dasBente/m3-modular-puzzle/README.md

# m3-modular-puzzle
The aim of this project is the implementation of a modular puzzle system including a default casing and some pre-implemented modules accompanying a controller that enables communication between a desired number of puzzle modules that can be exchanged at will.
