dasBente/m3-modular-puzzle/Modules/Module1/PCB/M3-Module1.brd

## EAGLE design Modules/Module1/PCB/M3-Module1.brd (2016-07-14)

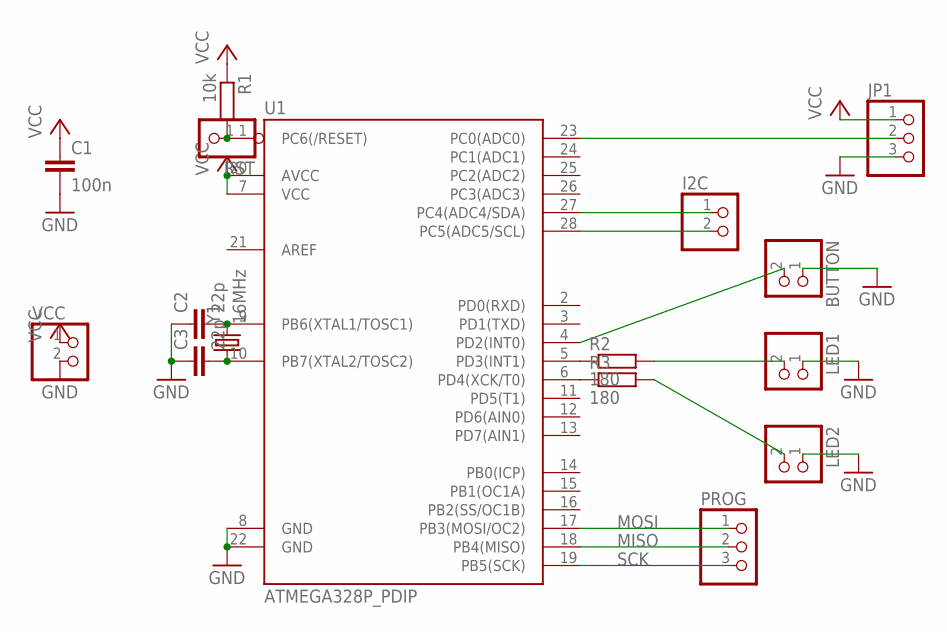
[picture p1: schematic M3-Module1.sch]

Parts:
BUTTON: PINHD-1X2; 1X02
C1: 100n; C025-025X050
C2, C3: 22p; C025-025X050
I2C: PINHD-1X2; 1X02
JP1: PINHD-1X3; 1X03
LED1, LED2: PINHD-1X2; 1X02
PROG: PINHD-1X3; 1X03
R1: 10k; 0204/5
R2, R3: 180; 0204/5
RST: PINHD-1X1; 1X01
U1: ATMEGA328P_PDIP; DIL28-3
VCC: PINHD-1X2; 1X02
Y1: 16MHz; HC49US

Connections:
GND: BUTTON.1, C1.2, C2.1, C3.1, JP1.3, LED1.1, LED2.1, U1.8 (GND), U1.22 (GND), VCC.2
MISO: PROG.2, U1.18 (PB4(MISO))
MOSI: PROG.1, U1.17 (PB3(MOSI/OC2))
unnamed: R1.2, RST.1, U1.1 (PC6(/RESET))
unnamed: I2C.1, U1.27 (PC4(ADC4/SDA))
unnamed: I2C.2, U1.28 (PC5(ADC5/SCL))
unnamed: C2.2, U1.9 (PB6(XTAL1/TOSC1)), Y1.2
unnamed: C3.2, U1.10 (PB7(XTAL2/TOSC2)), Y1.1
unnamed: BUTTON.2, U1.4 (PD2(INT0))
unnamed: R2.1, U1.5 (PD3(INT1))
unnamed: R3.1, U1.6 (PD4(XCK/T0))
unnamed: LED1.2, R2.2
unnamed: LED2.2, R3.2
unnamed: JP1.2, U1.23 (PC0(ADC0))
SCK: PROG.3, U1.19 (PB5(SCK))
VCC: C1.1, JP1.1, R1.1, U1.7 (VCC), U1.20 (AVCC), VCC.1

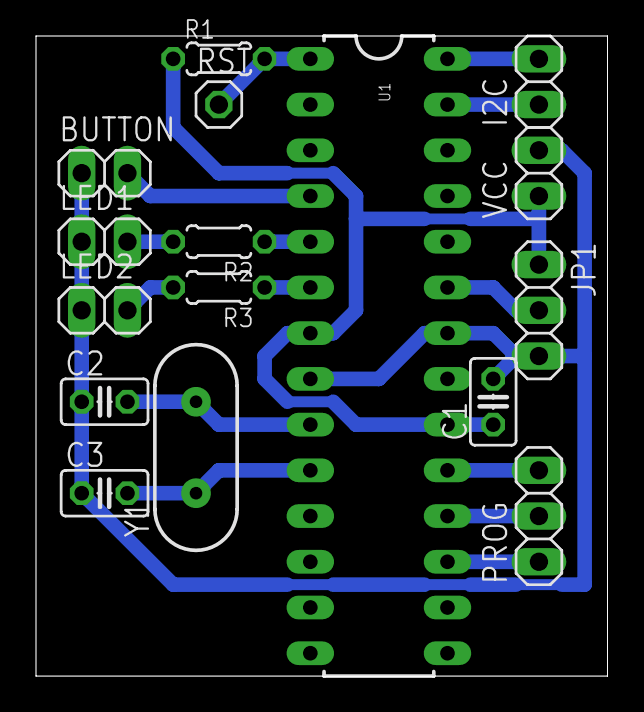
[picture p2: board M3-Module1.brd from above]

Board: 2 copper layers, 31.8 x 35.6 mm, 16 parts (0 on the bottom side), 16 nets.
