dasBente/m3-modular-puzzle/Modules/LogicModule/PCB/M3-LogicModule.brd

## EAGLE design Modules/LogicModule/PCB/M3-LogicModule.brd (2016-07-19)

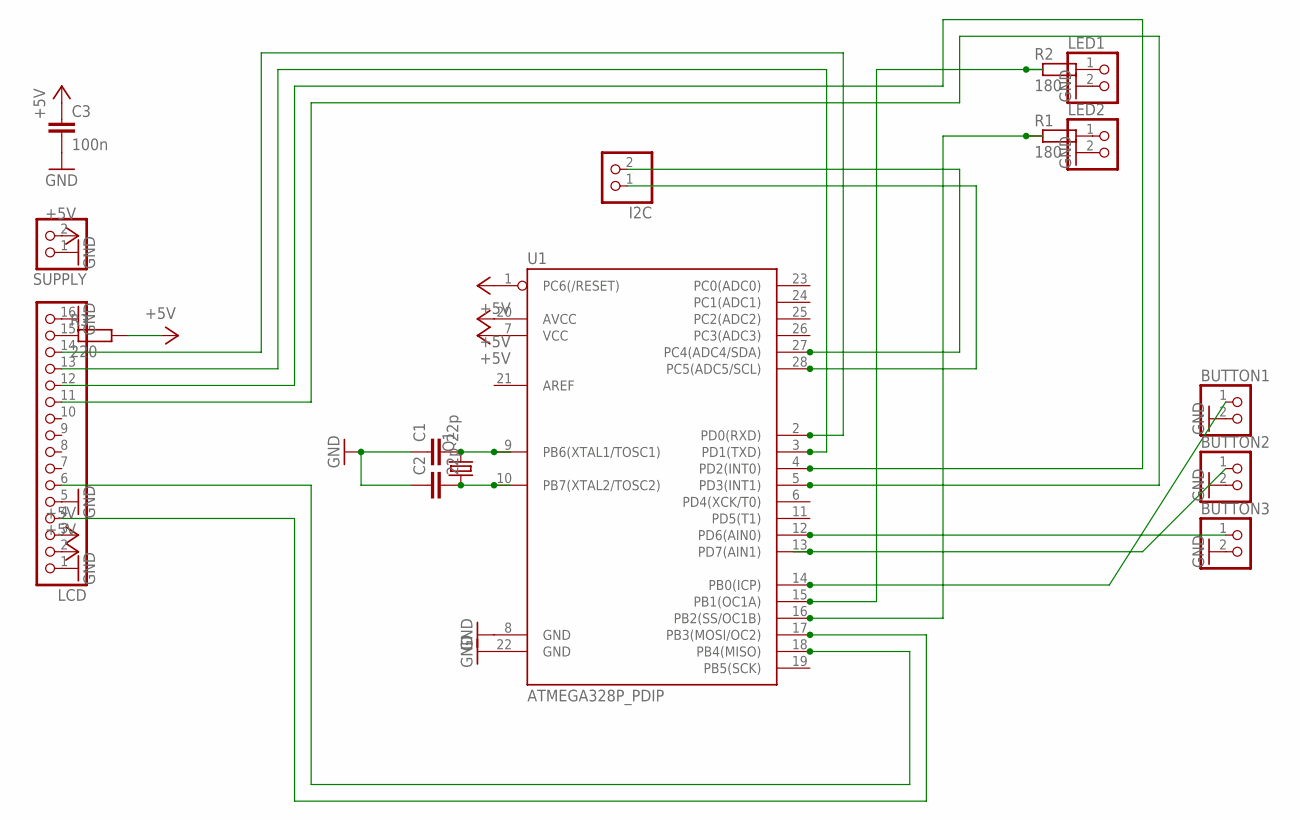
[picture p3: schematic M3-LogicModule.sch]

Parts:
BUTTON1, BUTTON2, BUTTON3: PINHD-1X2; 1X02
C1, C2: 22p; C025-025X050
C3: 100n; C2.5-3
I2C: PINHD-1X2; 1X02
LCD: PINHD-1X16; 1X16
LED1, LED2: PINHD-1X2; 1X02
Q1: CRYSTALHC49S; HC49/S
R1, R2: 180; 0309/12
R3: 220; 0309/10
SUPPLY: PINHD-1X2; 1X02
U1: ATMEGA328P_PDIP; DIL28-3

Connections:
+5V: C3.1, LCD.2, LCD.3, R3.2, SUPPLY.2, U1.1 (PC6(/RESET)), U1.7 (VCC), U1.20 (AVCC)
GND: BUTTON1.2, BUTTON2.2, BUTTON3.2, C1.1, C2.1, C3.2, LCD.1, LCD.5, LCD.16, LED1.2, LED2.2, SUPPLY.1, U1.8 (GND), U1.22 (GND)
unnamed: C1.2, Q1.2, U1.9 (PB6(XTAL1/TOSC1))
unnamed: LED2.1, R1.2
unnamed: LED1.1, R2.2
unnamed: R2.1, U1.15 (PB1(OC1A))
unnamed: R1.1, U1.16 (PB2(SS/OC1B))
unnamed: BUTTON1.1, U1.14 (PB0(ICP))
unnamed: BUTTON2.1, U1.13 (PD7(AIN1))
unnamed: BUTTON3.1, U1.12 (PD6(AIN0))
unnamed: C2.2, Q1.1, U1.10 (PB7(XTAL2/TOSC2))
unnamed: LCD.15, R3.1
unnamed: LCD.14, U1.2 (PD0(RXD))
unnamed: LCD.13, U1.3 (PD1(TXD))
unnamed: LCD.12, U1.4 (PD2(INT0))
unnamed: LCD.11, U1.5 (PD3(INT1))
unnamed: LCD.4, U1.17 (PB3(MOSI/OC2))
unnamed: LCD.6, U1.18 (PB4(MISO))
unnamed: I2C.1, U1.28 (PC5(ADC5/SCL))
unnamed: I2C.2, U1.27 (PC4(ADC4/SDA))

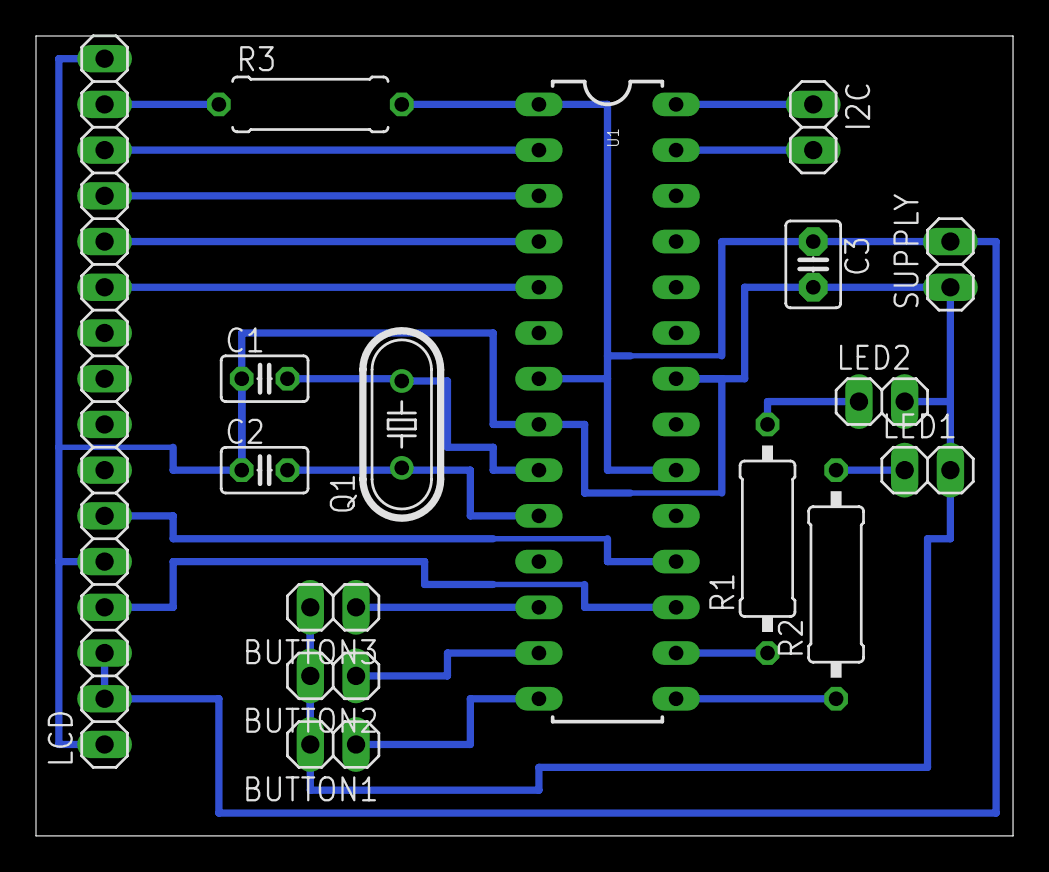
[picture p4: board M3-LogicModule.brd from above]

Board: 2 copper layers, 54.3 x 44.4 mm, 16 parts (0 on the bottom side), 20 nets.
