dasBente/m3-modular-puzzle/MainController/Schematic/main_controller.brd

## EAGLE design MainController/Schematic/main_controller.brd (2016-07-18)

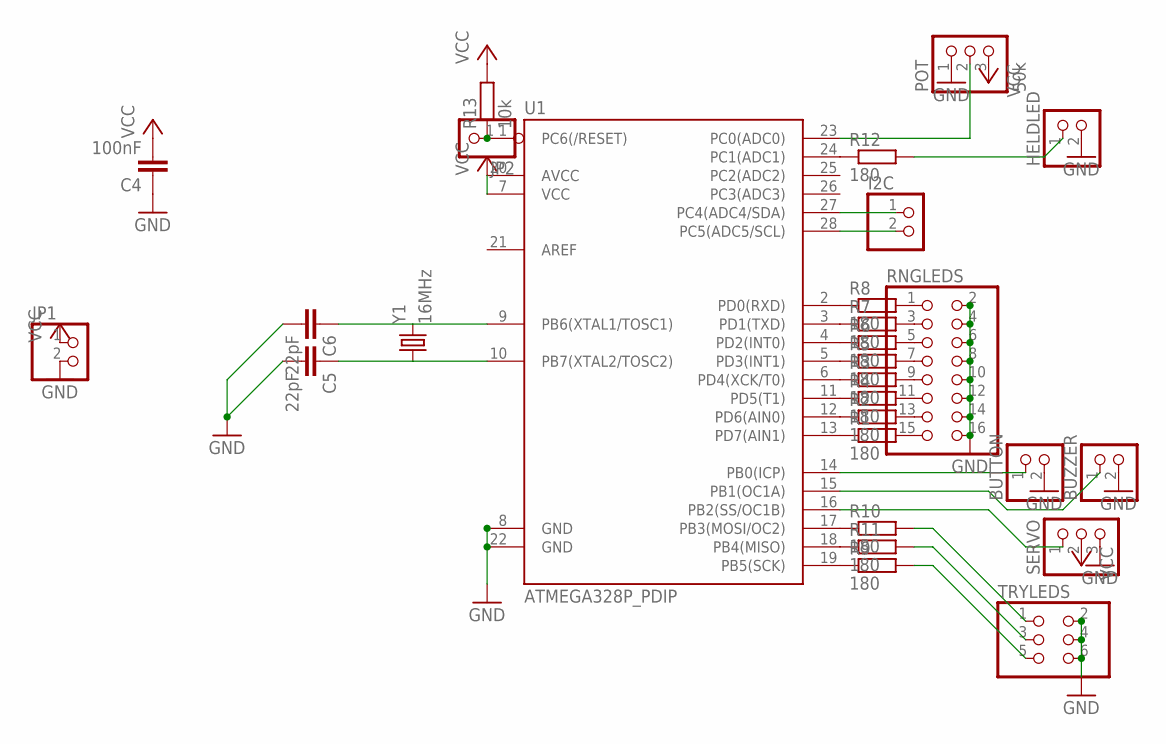
[picture p5: schematic main_controller.sch]

Parts:
BUTTON: PINHD-1X2; 1X02
BUZZER: PINHD-1X2; 1X02
C4: 100nF; C050-025X075
C5, C6: 22pF; C050-025X075
HELDLED: PINHD-1X2; 1X02
I2C: PINHD-1X2; 1X02
JP1: PINHD-1X2; 1X02
JP2: PINHD-1X1; 1X01
POT: 50k; 1X03
R1, R2, R3, R4, R5, R6, R7, R8, R9, R10, R11, R12: 180; 0207/7
R13: 10k; 0207/7
RNGLEDS: PINHD-2X8; 2X08
SERVO: PINHD-1X3; 1X03
TRYLEDS: PINHD-2X3; 2X03
U1: ATMEGA328P_PDIP; DIL28-3
Y1: 16MHz; HC49US

Connections:
GND: BUTTON.2, BUZZER.2, C4.1, C5.2, C6.2, HELDLED.2, JP1.2, POT.1, RNGLEDS.2, RNGLEDS.4, RNGLEDS.6, RNGLEDS.8, RNGLEDS.10, RNGLEDS.12, RNGLEDS.14, RNGLEDS.16, SERVO.3, TRYLEDS.2, TRYLEDS.4, TRYLEDS.6, U1.8 (GND), U1.22 (GND)
unnamed: C6.1, U1.9 (PB6(XTAL1/TOSC1)), Y1.2
unnamed: C5.1, U1.10 (PB7(XTAL2/TOSC2)), Y1.1
unnamed: POT.2, U1.23 (PC0(ADC0))
unnamed: R12.1, U1.24 (PC1(ADC1))
unnamed: I2C.1, U1.27 (PC4(ADC4/SDA))
unnamed: I2C.2, U1.28 (PC5(ADC5/SCL))
unnamed: R1.1, U1.13 (PD7(AIN1))
unnamed: R2.1, U1.12 (PD6(AIN0))
unnamed: R3.1, U1.6 (PD4(XCK/T0))
unnamed: R4.1, U1.11 (PD5(T1))
unnamed: R5.1, U1.5 (PD3(INT1))
unnamed: R6.1, U1.4 (PD2(INT0))
unnamed: R7.1, U1.3 (PD1(TXD))
unnamed: R8.1, U1.2 (PD0(RXD))
unnamed: R1.2, RNGLEDS.15
unnamed: R2.2, RNGLEDS.13
unnamed: R3.2, RNGLEDS.9
unnamed: R4.2, RNGLEDS.11
unnamed: R5.2, RNGLEDS.7
unnamed: R6.2, RNGLEDS.5
unnamed: R7.2, RNGLEDS.3
unnamed: R8.2, RNGLEDS.1
unnamed: R9.1, U1.19 (PB5(SCK))
unnamed: R10.1, U1.17 (PB3(MOSI/OC2))
unnamed: R11.1, U1.18 (PB4(MISO))
unnamed: HELDLED.1, R12.2
unnamed: R9.2, TRYLEDS.5
unnamed: R11.2, TRYLEDS.3
unnamed: R10.2, TRYLEDS.1
unnamed: BUTTON.1, U1.14 (PB0(ICP))
unnamed: BUZZER.1, U1.15 (PB1(OC1A))
unnamed: SERVO.1, U1.16 (PB2(SS/OC1B))
unnamed: JP2.1, R13.1, U1.1 (PC6(/RESET))
VCC: C4.2, JP1.1, POT.3, R13.2, SERVO.2, U1.7 (VCC), U1.20 (AVCC)

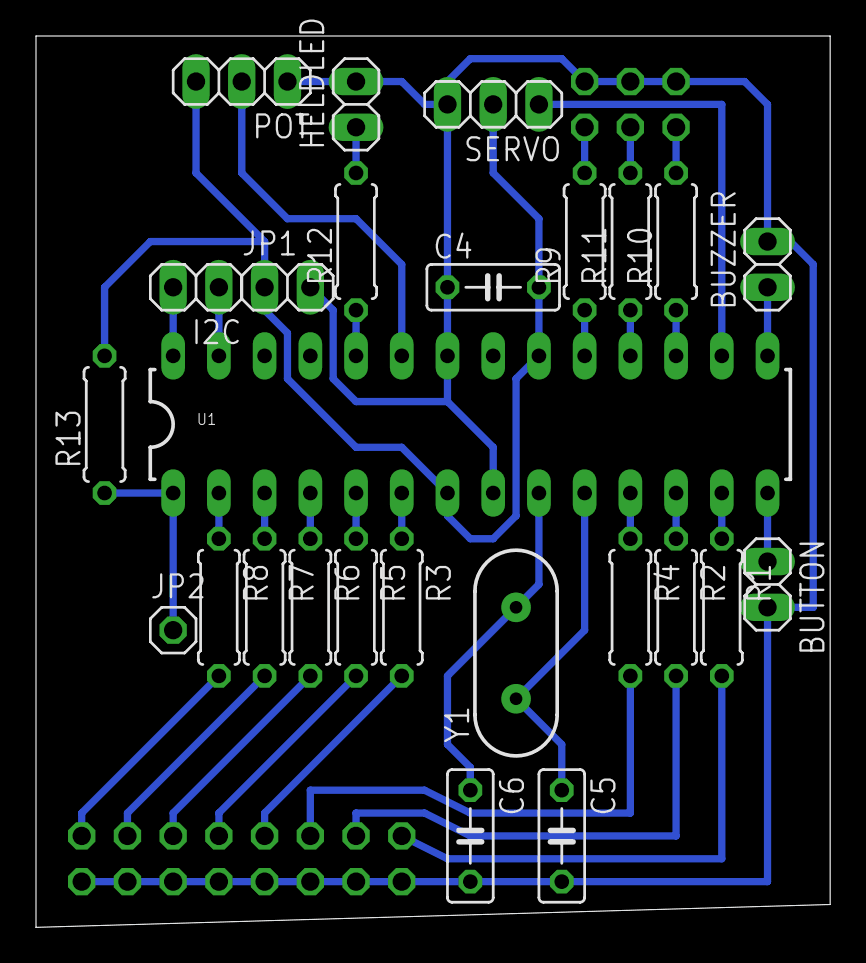
[picture p6: board main_controller.brd from above]

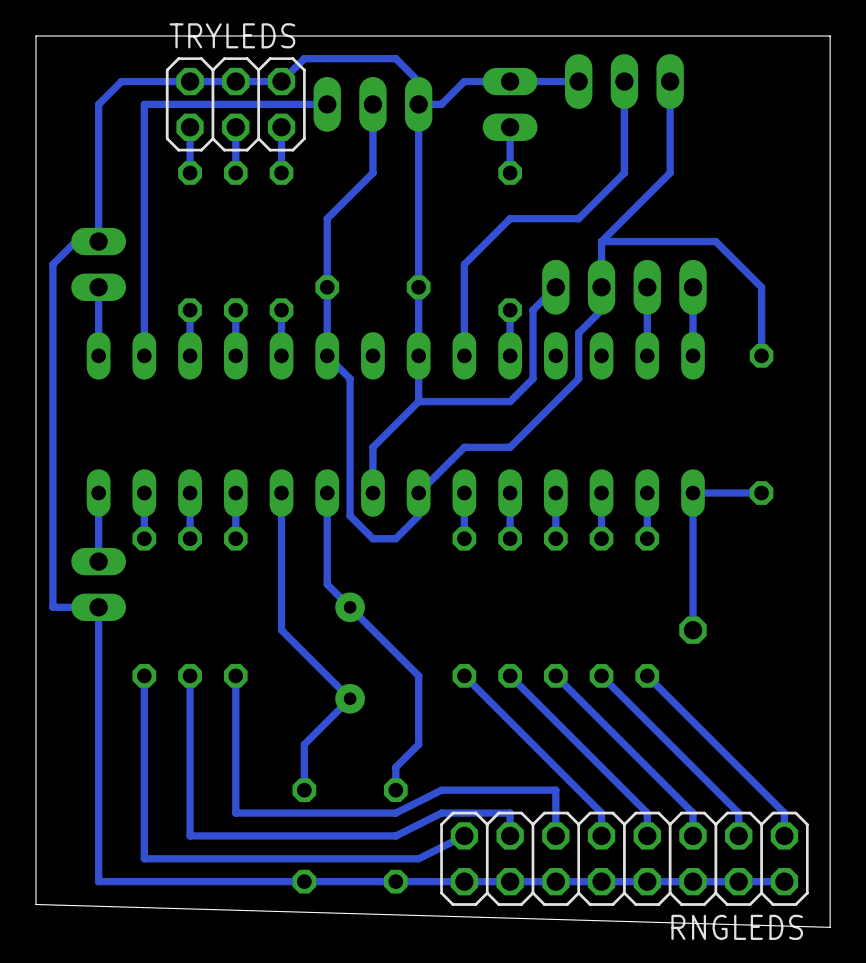
[picture p7: board main_controller.brd from below]

Board: 2 copper layers, 44.1 x 49.5 mm, 28 parts (2 on the bottom side), 35 nets.
