dasBente/m3-modular-puzzle/LogicModule/Instructions/Instructions.tex

\documentclass[a4paper, 12pt]{article}
\usepackage[utf8]{inputenc}
\usepackage{geometry}

\geometry{a4paper, left=15mm, right=20mm, top=2cm, bottom=2cm}
\setlength{\parskip}{1em}
\setlength{\parindent}{0pt}

\begin{document}

\section*{Solution instructions for the logic module}

The display shows a propositional logical formula with four variables. You have to change the operators in order to make the interpretation true. The last 4 LEDs on the main module represent the four variables: the last LED is on, if the fourth variable is true.

\end{document}
