dasBente/m3-modular-puzzle/Module1/Instructions/Instructions.tex

\documentclass[a4paper, 12pt]{article}
\usepackage[utf8]{inputenc}
\usepackage{geometry}

\geometry{a4paper, left=15mm, right=20mm, top=2cm, bottom=2cm}
\setlength{\parskip}{1em}
\setlength{\parindent}{0pt}

\begin{document}

\section*{Solution instructions for module 1}

There are six resistors of which you can choose. Your comrade has to pick the right one, depending on the eight LEDs on the main module. The first match is the correct answer:
\begin{itemize}
\setlength{\itemsep}{0pt}
\item If the first LED is on, the correct color code is brown-black-gold-gold.
\item If the second LED is on, the color code is brown-black-black-gold.
\item If the third LED is on, the color code is brown-grey-brown-gold.
\item If the fourth LED is on, the correct resistor displays the color code brown-black-red-gold.
\item If the fifth LED is on, the correct color code is brown-black-orange-gold.
\item If the sixth LED is on, the color code must be brown-black-yellow-gold.
\end{itemize}

\end{document}
