dasBente/m3-modular-puzzle/Modules/LogicModule/Instructions/Instructions.pdf

## Solution instructions for the logic module

The display shows a propositional logical formula with four variables. You have to change the operators in order to make the interpretation true. The first 4 LEDs on the main module represent the four variables backwards: the first LED is on, if the fourth variable is true.

1
