dasBente/m3-modular-puzzle/(threads)

Thread 1 (2016-06-10):

LCD Kontrastprobleme

dasBente, 2016-06-10:
Bei der momentanen Verschaltung von Mikrocontroller und LCD gibt es noch Probleme mit dem Kontrast. Das liegt vermutlich daran, dass der MSP430 nur eine Ausgangsspannung von 3.3V liefert. Es könnte sein, dass der verwendete LCD (Qapass 1602A) eine größere negative Kontrastspannung benötigt.
Gegebenenfalls muss die Versorgungsspannung für den LCD (möglicherweise Probleme durch Fremdversorgung?) oder die negative Spannung an V0 erhöht werden.

dasBente, 2016-06-12:
Ich werde mal die Idee weiterverfolgen, eine 5V Spannungsversorgung zu nutzen und die auf 3.3V Versorgungsspannung für den mC runterzuregeln.

dasBente, 2016-06-15:
Hat sich erledigt, die verbleibende Spielzeit wird statt dessen analog erfolgen. Außerdem wechselt die Entwicklung mit dem nächsten Commit auf master auf einen Arduino.

Closed 2016-06-15.

Thread 3 (2016-06-11):

Communication between Controller and Modules

dasBente, 2016-06-11:
It is necessary for the main controller to communicate with the other modules of the puzzle in order to control game state changes such as a module being solved or the player commiting a error and enable randomization of the games.

dasBente, 2016-06-22:
I added @FlixCoder as he already worked on establishing a protocol to be used for communication between modules. The implementation is probably going to make use of I2C and Arduinos Wire library.

dasBente, 2016-07-07:
The communication between modules works now. There is still a bit of error handeling and some safety measures to be implemented though.

Closed 2016-07-07.

Thread 5 (2016-06-22):

Emulate fluctuations of the needle-indicator

dasBente, 2016-06-22:
The needles of real-life analogous indicators such as pressure gauges fluctuate to some degree. This should be emulated to achieve a somewhat more immersive feeling of the puzzle.

dasBente, 2016-06-22:
The fluctuation has to be included into the timer code. Adding a deviance to the servo position for every cycle of loop is barely (,if at all) noticable. Probably every 100ms or so by a factor of around 2-5 degrees in each direction should be somewhat realistic looking.

Thread 6 (2016-06-22):

Design of the outer casing

dasBente, 2016-06-22:
A design including dimensions for the games case has to be made. @ReneNiewianda is already on this and has provided a initial design to be cut using a laser cutter.
