dasBente/m3-modular-puzzle/Modules/Module1/Code/M3-Module1/M3-Module1.ino

#include <Wire.h>

#define PINBUTTON 2
#define PINLEDGREEN 3
#define PINLEDRED 4
#define PINADC A0

#define LED_BLINK_TIME 100 //100*10ms before it switches on/off (10ms by delay in loop)

byte i2cAnswer=0xFF;
byte randomByte=0;
byte gameState=0; //0 - stopped, 1 - running, 2 - fail (wait for request before resume), 3 - solved, x - internal error
int expectedADCvalMin=0;
int expectedADCvalMax=1023;


void setup()
{
    //define pin modes
    pinMode(PINBUTTON, INPUT_PULLUP);
    pinMode(PINLEDGREEN, OUTPUT);
    pinMode(PINLEDRED, OUTPUT);
    //initialize i2c interface
    Wire.begin(8);
    Wire.onReceive(receiveEvent);
    Wire.onRequest(requestEvent);
}

void loop()
{
    //led control (blinking when not solved)
    static int ledTime=LED_BLINK_TIME;
    static bool ledsOn=false;
    if (ledTime==0)
    {
        if (gameState==0)
        {
            ledsOn=false;
            digitalWrite(PINLEDGREEN,0);
            digitalWrite(PINLEDRED,0);
        }
        else if (gameState==1 || gameState==2) //not solved yet
        {
            //switch on/off
            ledsOn=!ledsOn;
            if (ledsOn)
            {
                digitalWrite(PINLEDGREEN,1);
                digitalWrite(PINLEDRED,1);
            }
            else
            {
                digitalWrite(PINLEDGREEN,0);
                digitalWrite(PINLEDRED,0);
            }
            ledTime=LED_BLINK_TIME;
        }
        else if (gameState==3)
        {
            ledsOn=true;
            digitalWrite(PINLEDGREEN,1);
            digitalWrite(PINLEDRED,0);
        }
    }
    else ledTime--;
    //game
    if (gameState==1) //game is running
    {
        if (digitalRead(PINBUTTON)==0) //button pressed
        {
            int adc=analogRead(PINADC);
            if (adc>=expectedADCvalMin && adc<=expectedADCvalMax) //correct connection
            {
                gameState=3;
                //light green LED only for completion indication
                ledsOn=true;
                digitalWrite(PINLEDGREEN,1);
                digitalWrite(PINLEDRED,0);
                ledTime=0; //displays infintely long unless gamestate changes
            }
            else //wrong connection
            {
                gameState=2;
                //light red LED only for two LED blink times
                ledsOn=true;
                digitalWrite(PINLEDGREEN,0);
                digitalWrite(PINLEDRED,1);
                ledTime=2*LED_BLINK_TIME;
            }
            
            while (digitalRead(PINBUTTON)==0) delay(10); //wait for button release
        }
    }
    //delay
    delay(10);
}

void receiveEvent(int numBytes)
{
    byte buffer[numBytes];
    for (int i=0; i<numBytes; i++) buffer[i]=(byte)Wire.read();

    switch(buffer[0])
    {
        case 0: //reserved
            i2cAnswer=0; //fail
            break;
        case 1: //game start / reset
            randomByte=buffer[1];
            //set ADC min/max (compare resistor is 180 Ohm)
            if (randomByte&0x80) //resistor 1 (1 Ohm)
            {
                expectedADCvalMin=4;
                expectedADCvalMax=7;
            }
            else if (randomByte&0x40) //resistor 2 (10 Ohm)
            {
                expectedADCvalMin=52;
                expectedADCvalMax=56;
            }
            else if (randomByte&0x20) //resistor 3 (180 Ohm)
            {
                expectedADCvalMin=510;
                expectedADCvalMax=514;
            }
            else if (randomByte&0x10) //resistor 4 (1 kOhm)
            {
                expectedADCvalMin=865;
                expectedADCvalMax=870;
            }
            else if (randomByte&0x08) //resistor 5 (10 kOhm)
            {
                expectedADCvalMin=1004;
                expectedADCvalMax=1008;
            }
            else/* if (randomByte&0x04)*/ //resistor 6 (100 kOhm)
            {
                expectedADCvalMin=1020;
                expectedADCvalMax=1023;
            }
            
            gameState=1; //running
            i2cAnswer=1; //ack
            break;
        case 2: //game information request
            if (gameState<=1) i2cAnswer=0; //nothing
            else if (gameState==2) i2cAnswer=1; //user fail
            else if (gameState==3) i2cAnswer=2; //user solved
            else i2cAnswer=3; //internal error
            break;
        case 3: //game end
            gameState=0;
            i2cAnswer=1; //ack
            break;
        default:
            i2cAnswer=0; //fail
            break;
    }
}

void requestEvent()
{
    //if (i2cAnswer==0xFF) doSomething(); //answer not ready
    Wire.write(i2cAnswer); //send answer byte
    i2cAnswer=0xFF; //set answer byte not ready
    
    //resume game after fail was noticed
    if (gameState==2) gameState=1;
}
