dasBente/m3-modular-puzzle/(commit log)

2016-06-10 Hauptprogrammdatei für Steuereinheit erstellt
    Steuerprogramm für die Steuereinheit erstellt und Verschaltung von
    Mikrocontroller und LCD vorerst in die .ino eingetragen.
2016-06-10 .gitignore hinzugefügt
    Standard .gitignore mit zusätzlichen Einträgen für KiCAD dem Projekt
    hinzugefügt
2016-06-10 KiCAD Projekt für die Steuereinheit angelegt
    Zusätzlich Schaltung von MSP430G2553 mit LCD hinzugefügt.
    [Steuereinheit.kicad_pcb, Steuereinheit.sch]
2016-06-10 Initialisierung für LCD
    Code zur Initialisierung des LCDs
2016-06-11 utils hinzugefügt
    Datei für Hilfsfunktionen und Makros erstellt
2016-06-12 Schaltplan für Steuereinheit angepasst
    Stromquelle auf 5V geändert, zusätzliche Schiene für 3.3V eingefügt.
    Schaltung zum runterpegeln fehlt allerdings noch. Weiterhin habe ich die
    Verschaltung des LCD mit dem Mikrocontroller etwas Kompakter formatiert
    um Platz für zusätzliche Schaltelemente zu schaffen.
    [Steuereinheit.sch]
2016-06-15 Erstes BoxDesign
    Ein vorläufiges BoxDesign für die Verschalung (3mm Materialdicke)
2016-06-15 Code aufgeräumt für wechsel auf analog
    Der LCD wird durch einen analogen Zeiger an einem Servo-Motor ersetzt,
    der von einem mit Potentiometer festgelegten Punkt herunter zählt. Zu
    diesem Zweck habe ich den bereits bestehenden Code verworfen.
2016-06-15 Anpassung des Schaltplans für analogen Zeiger
    Der analoge Indikator für die verbleibende Zeit soll mittels eines
    Servos realisiert werden, der dementsprechend mit dem mC verschaltet
    werden muss. Der Poti dient dem Einstellen der Rundendauer.
    [Steuereinheit.sch]
2016-06-15 Auslesen eines Potis implementiert
    Dieser Code entspricht größtenteils dem Codebeispiel "Knob" aus der
    Arduino-Entwicklunksumgebung, da dieses bereits die grundlegende
    Funktionalität abdeckt, den Servo entsprechend der Drehung des Potis
    einzustellen.
2016-06-16 Knopfdruck zum halten des Zählerstandes hinzugefügt
    Durch einen Druckknopf kann jetzt der Wert von "time_remaining"
    festgelegt werden.
2016-06-16 Debug Code hinzugefügt
    Der Code verfügt jetzt über Debugelemente. Explizit deutet die
    On-Board-LED des Genuino Boards hier darauf hin, ob "hold" bereits
    gesetzt wurde.
2016-06-20 enum für den Spielstatus ergänzt
    Das enum GameState soll der Steuerung des Spielzustandes dienen. Es sind
    allerdings vielleicht noch zu viele Zustände enthalten, die ich erstmal
    Sicherheitshalber zugefügt habe, um logische Schritte im Spielfluss
    abzudecken.
2016-06-20 Logik auf GameState abgeändert
    Die Logik des Programmes läuft jetzt durch GameState ab und nicht mehr
    über den buttonState und hold. Weiterhin wurde hold in held umbenannt,
    was die Funktion der Variable als Angabe, ob der Button gehalten wird,
    einfacherer inferierbar machen sollte.
2016-06-20 Countdowntimer mit Servo
    Der Servo emuliert jetzt einen heruntertickenden Zeiger um die
    verbleibende Spielzeit zu indizieren.
2016-06-22 Translated comments from german to english
    For the sake of easier accessibility, the code and commits are to be in
    english from now on. Also, all file- and directorynames have been
    translated.
    [Schematic.kicad_pcb, Schematic.sch]
2016-06-22 Removed deviance value
    The deviance value that should emulate needle fluctuations is removed
    for now as the current implementation simply does not do anythin,
    probably because of the amount of changes to the value per second.
2016-06-30 Removed match for *-cache.lib
    This file is crucial for retaining the intended look for components in schematics.
2016-06-30 Changed GS_INIT to GS_RESET
    Added changed the name of GS_INIT to the semantically more correct
    GS_RESET, as this state will be used to reset game information.
    Also added changed some of the logic involving game states to fit
    into the new modell using GS_RESET:
    - added reset_game()-Function for resetting game state
    - changed and extended logic in loop()
    [MainController.ino]
2016-06-30 Implemented Indicator for remaining tries
    The player can read from a set of three LEDs how often he can still fail at
    solving one of the puzzle modules.
    This adds another fail state to the game other than running out of time.
    The remaining time can be set by setting the game time:
    - <=120s equals one try
    - <=240s equals two tries
    - otherwise the player is given three tries
    This might still be subject to change for balancing reasons or substituted
    by some other kind of input or method to set the amount of tries.
    [MainController.ino]
2016-07-01 first electronic schematic
    [module.kicad_pcb, module.sch]
2016-07-05 ready for test, prototype
    [module.sch]
2016-07-05 ready for testing, prototype
2016-07-06 Initialization of I2C connection
    This commit sets up the basics of I2C connection between the controller
    and the modules.
    Also, a array to contain module addresses is implemented.
2016-07-06 Implemented module initialization
    Now, the modules are initialized using the init_modules function. The
    modules are reinitialized before each game round to allow swapping
    modules inbetween games.
    [MainController.ino]
2016-07-06 Implemented I2C communication
    This commits implements most of the I2C communication for the
    main-controller. This commit still remains to be tested.
2016-07-06 Code update: small resume fix after fail
    [M3-Module1.ino]
2016-07-07 Added Debug messages to monitor I2C
    Some debug messages printed to serial monitoring which (meaningfull)
    packages are received and also indicating whether these are processed
    correctly.
    [MainController.ino]
2016-07-07 Fixed bug not updating remaining tries
    Forgot to actually assign the freshly updated number of tries to the
    tries-Variable.
    [MainController.ino]
2016-07-07 Updated Schematic
    Added the push button and some LEDs currently used by the main
    controllers programm. Also added bus lines for the SDA and SCL pins
    required for I2C to work.
    [Schematic.sch]
2016-07-07 Added communication error handling
    Added error handling in case of internal module error. Also refactored
    some of the communication code.
    [MainController.ino]
2016-07-14 switched to EAGLE
    [M3-Module1.brd, M3-Module1.sch]
2016-07-17 Changed microcontrollers Pinlayout (in the code)
    Changes in the KiCAD file are inbound too. Probably including a switch
    to Eagle CAD
2016-07-17 Added some more feedback in case of win/loss
    Also included is the increase in timer speed if the player caused a fail
    to trigger.
    [MainController.ino]
2016-07-17 added LogicModule files
    [M3-LogicModule.brd, M3-LogicModule.sch]
2016-07-18 Switched KiCAD for eagle project
    [Schematic.kicad_pcb, Schematic.sch, main_controller.brd, main_controller.sch]
2016-07-18 Switched to Pull-up. Fixed Blink.
    [MainController.ino]
2016-07-18 Face of the clock to be laserengraved
2016-07-19 small fix + cleanup
    [M3-LogicModule.brd, M3-LogicModule.sch, M3-Module1.brd, M3-Module1.sch]
2016-07-19 Refactoring and additions
    Added call to set_RNG_LEDs to actually set the LEDs (probably forgot
    this one because I was not able to test this).
    Also added additional call to shutdown_modules after loss through
    running out of lives. Refactored code accordingly.
    Lastly, reduced the number of modules on internal module error (win
    state) to ensure that the player is not punished for any module
    implementation errors.
    [MainController.ino]
2016-07-20 Hopefully fixed module solves
    A bug would trigger GS_WON when one module signaled solve, as the module will keep sending solve. Redefined win state.
    [MainController.ino]
2016-07-20 Final Box-Design
    The final box-Design for the case and the modules
2016-07-24 Added some details to the face plate for ease of use
    Basically, added stuff so the module can now be cut/engraved in one go.
2016-07-26 Some small changes to the PCB and schematic
